TronusPrime/VoiceProject/Mk2BOM.xlsx

Reference | Value | Datasheet | Footprint | Qty | LCSC PART
C1,C13,C14,C15,C16 | 10uF | ~ | Capacitor_SMD:C_0402_1005Metric | 5 | C15525
C2 | 22uF | ~ | Capacitor_SMD:C_0402_1005Metric | 1 | C3845593
C5 | 22uF | ~ | Capacitor_SMD:C_0805_2012Metric | 1 | C29277
C6 | 0.1uF | ~ | Capacitor_SMD:C_0805_2012Metric | 1 | C126469
C3,C4,C7,C8,C9,C10,C12 | 0.1uF | ~ | Capacitor_SMD:C_0402_1005Metric | 7 | C1525
C11 | 2.2uF | ~ | Capacitor_SMD:C_0402_1005Metric | 1 | C60078
C17 | 2.2uF | ~ | Capacitor_SMD:C_0805_2012Metric | 1 | C1728
C18,C19 | 2.2nF | ~ | Capacitor_SMD:C_0402_1005Metric | 2 | C1531
D1 | 3V | ~ | LED_SMD:LED_0603_1608Metric | 1 | C193191
D2 | LED | ~ | LED_SMD:LED_0603_1608Metric | 1 | C2994781
J2 | Conn_01x06_Socket | ~ | B6B_XH_A:JST_B6B-XH-A | 1 | C144397
J3 | Screw_Terminal_01x02 | ~ | B2B_XH_A:JST_B2B-XH-A | 1 | C158012
J4,J5 | Conn_01x03_Socket | ~ | B3B_XH_A:JST_B3B-XH-A | 2 | C161870
R1,R2 | 5.1k | ~ | Resistor_SMD:R_0402_1005Metric | 2 | C25905
R3 | 0 | ~ | Resistor_SMD:R_0402_1005Metric | 1 | C17168
R4 | 10k | ~ | Resistor_SMD:R_0402_1005Metric | 1 | C25744
R5,R6 | 470 | ~ | Resistor_SMD:R_0402_1005Metric | 2 | C25167
R7 | 350 | ~ | Resistor_SMD:R_0402_1005Metric | 1 | C25107
R8 | 100 | ~ | Resistor_SMD:R_0402_1005Metric | 1 | C98836
SW1,SW2 | SW_Push | ~ | Switch:SW2_PTS636 SM25F SMTR LFS_CNK | 2 | C2689642
U1 | AMS1117-3.3 | http://www.advanced-monolithic.com/pdf/ds1117.pdf | Package_TO_SOT_SMD:SOT-223-3_TabPin2 | 1 | C6186
U2 | ESP32-WROOM-E | https://www.espressif.com/sites/default/files/documentation/esp32-wroom-32e_esp32-wroom-32ue_datasheet_en.pdf | Espressif:ESP32-WROOM-32E | 1 | C701343
U3 | PCM5102A | https://www.ti.com/lit/ds/symlink/pcm5102a.pdf | Package_SO:TSSOP-20_4.4x6.5mm_P0.65mm | 1 | C107671
USB1 | TYPE-C 16PIN 2MD(073) |  | easyeda2kicad:USB-C-SMD_TYPE-C-6PIN-2MD-073 | 1 | C2765186
