TronusPrime/VoiceProject/SpeakerR/SpeakerR_BOM.xlsx

Reference | Value | Datasheet | Footprint | Qty | LCSC
C1,C4 | 20uF | ~ | Capacitor_SMD:C_1812_4532Metric | 2 | C76690
C2,C3,C6 | 1uF | ~ | Capacitor_SMD:C_0402_1005Metric | 3 | C52923
C5 | 0.1uF | ~ | Capacitor_SMD:C_0402_1005Metric | 1 | C1581
FB1,FB2 | FerriteBead | ~ | Inductor_SMD:L_0603_1608Metric | 2 | C1002
J1 | Conn_01x02_Socket | ~ | easyeda2kicad:CONN-TH_B2B-XH-A-LF-SN | 1 | C158012
J2 | Conn_01x03_Socket | ~ | easyeda2kicad:CONN-TH_3P-P2.50_B3B-XH-AM-LF-SN | 1 | C161870
R1 | 10k | ~ | Resistor_SMD:0405_1005Metric | 1 | C25531
RV1 | 10k |  | Potentiometer | 1
U1 | PAM8406D | https://www.diodes.com/assets/Datasheets/PAM8406.pdf | Package_SO:SOP-16_3.9x9.9mm_P1.27mm | 1 | C86270
