TronusPrime/VoiceProject/Amp12VMk1PCB/Amp12VMk1PCB.kicad_pcb

## KiCad design Amp12VMk1PCB/Amp12VMk1PCB.kicad_pcb (2024-11-20)

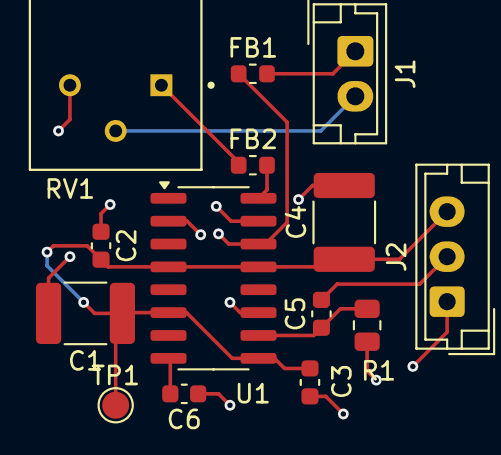
[picture p1: board Amp12VMk1PCB.kicad_pcb from above]

Board: 2 copper layers, 14 parts (0 on the bottom side), 10 nets.

Parts:
C1, C4: 20uF; C_1812_4532Metric
C2, C3, C6: 1uF; C_0603_1608Metric
C5: 0.1uF; C_0603_1608Metric
FB1, FB2: FerriteBead; L_0603_1608Metric
J1: Conn_01x02_Socket; JST_EH_B2B-EH-A_1x02_P2.50mm_Vertical
J2: Conn_01x03_Socket; JST_EH_B3B-EH-A_1x03_P2.50mm_Vertical
R1: 10k; R_0805_2012Metric
RV1: 10k; POT_3310P-025-103L
TP1: TestPoint; TestPoint_Pad_D1.5mm
U1: PAM8406D; SOP-16_3.9x9.9mm_P1.27mm

Connections:
+5V: C1.1, C2.2, C3.2, C4.1, J2.3, TP1.1, U1.4 (PVDDL), U1.6 (VDD), U1.9 (MODE), U1.13 (PVDDR)
/inR: C5.2, J2.2
GND: C1.2, C2.1, C3.1, C4.2, C6.1, J2.1, R1.1, RV1.3, U1.2 (PGNDL), U1.11 (GND), U1.15 (PGNDR)
unnamed: FB2.1, RV1.1
unnamed: FB1.2, J1.1
unnamed: J1.2, RV1.2
unnamed: FB2.2, U1.16 (+OUT_R)
unnamed: FB1.1, U1.14 (-OUT_R)
unnamed: C5.1, R1.2, U1.10 (INR)
unnamed: C6.2, U1.8 (VREF)
