TronusPrime/VoiceProject/MicPCB/MicPCB/MicPCB.kicad_pcb

## KiCad design MicPCB/MicPCB/MicPCB.kicad_pcb (2024-11-20)

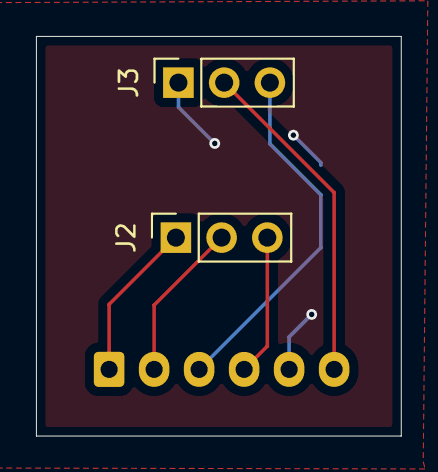
[picture p5: board MicPCB.kicad_pcb from above]

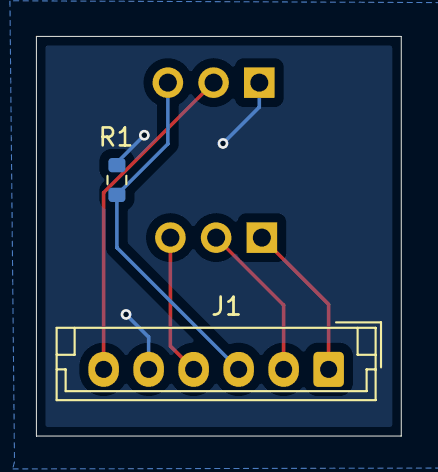
[picture p6: board MicPCB.kicad_pcb from below]

Board: 2 copper layers, 20.3 x 22.2 mm, 4 parts (2 on the bottom side), 6 nets.

Parts:
J1: 3.3 sel; JST_EH_B6B-EH-A_1x06_P2.50mm_Vertical
J2, J3: Conn_01x03_Socket; PinSocket_1x03_P2.54mm_Vertical
R1: 10k; R_0603_1608Metric

Connections:
+3.3V: J1.6, J3.2
/bclk: J1.4, J2.3
/lrcl: J1.2, J2.2
/sd: J1.3, J3.3, R1.1
/sel: J1.1, J2.1
GND: J1.5, J3.1, R1.2
