TronusPrime/VoiceProject/VoiceProjectPCB/VoiceProjectPCB.kicad_pcb

## KiCad design VoiceProjectPCB/VoiceProjectPCB.kicad_pcb (2024-11-20)

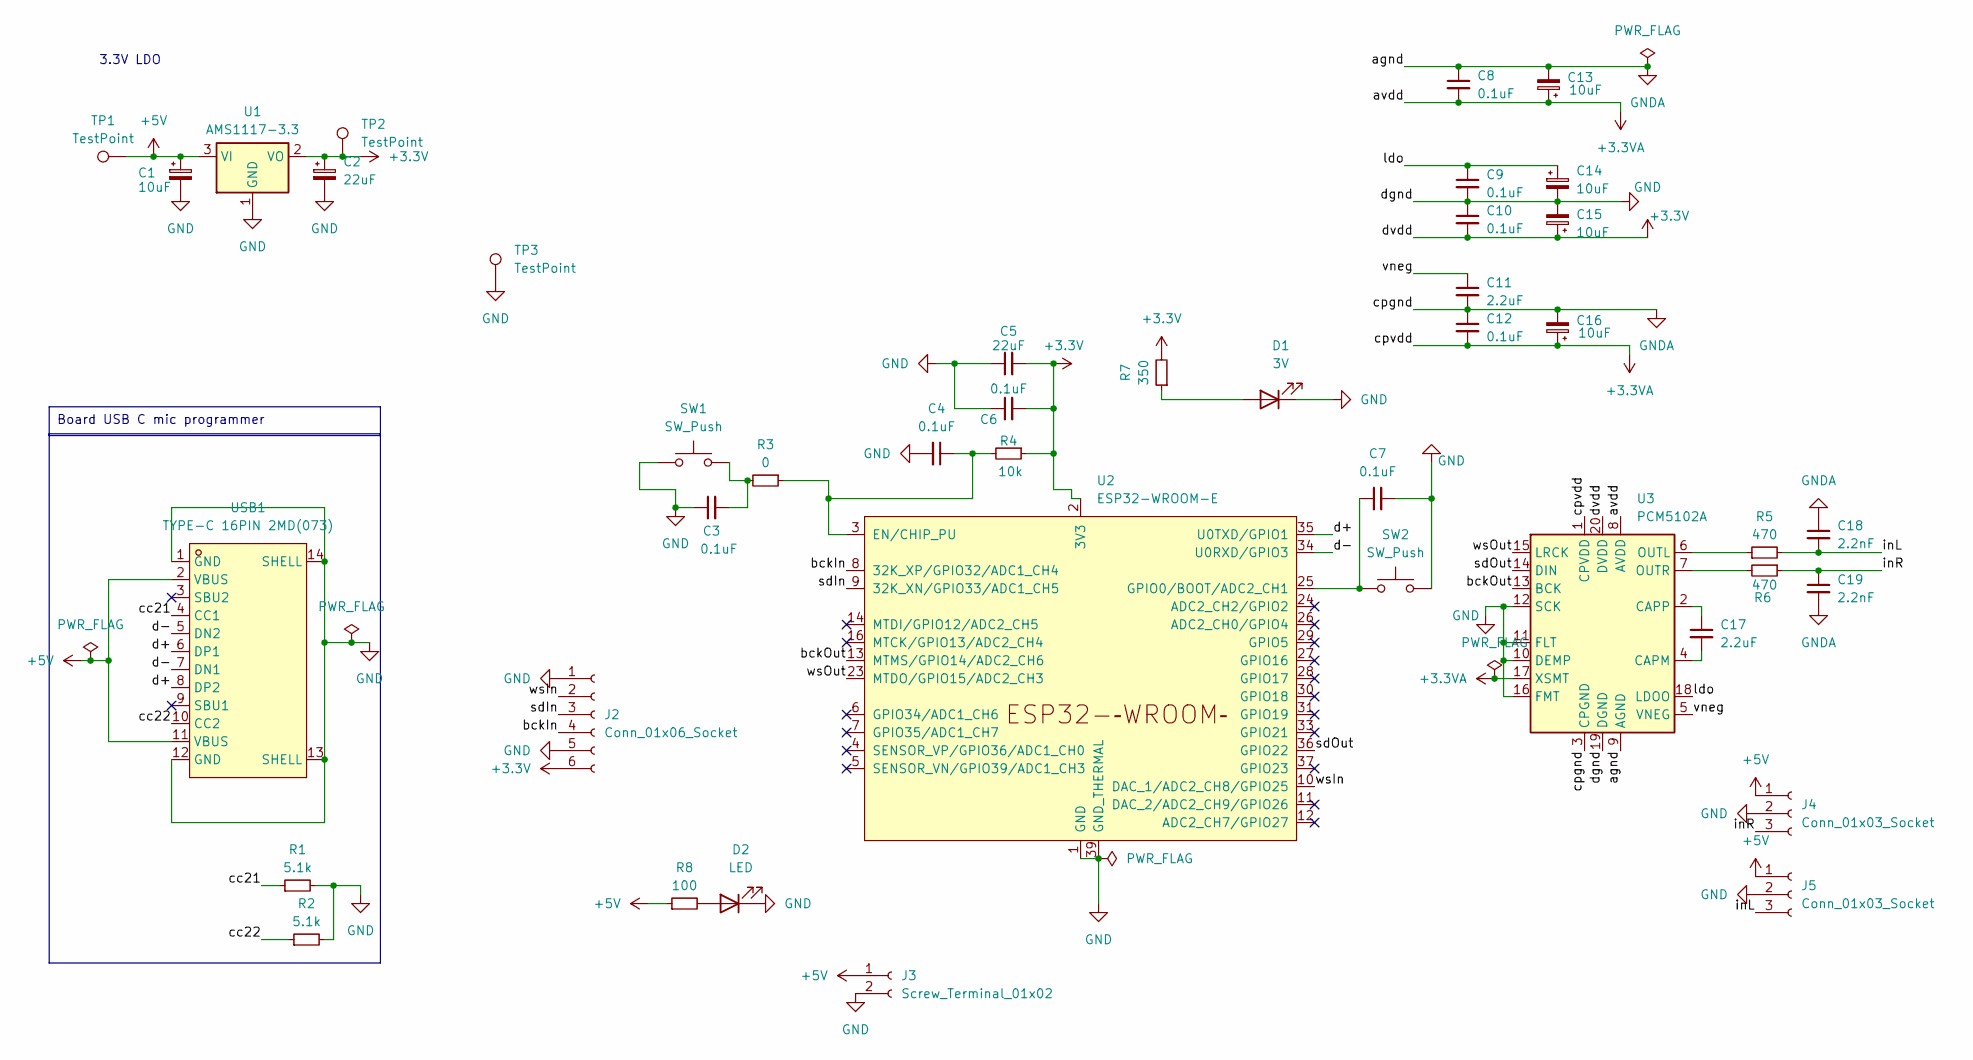
[picture p7: schematic VoiceProjectPCB.kicad_sch]

Parts:
C1, C13, C14, C15, C16: 10uF; C_0402_1005Metric
C2: 22uF; C_0402_1005Metric
C3, C4, C7, C8, C9, C10, C12: 0.1uF; C_0402_1005Metric
C5: 22uF; C_0805_2012Metric_Pad1.18x1.45mm_HandSolder
C6: 0.1uF; C_0805_2012Metric_Pad1.18x1.45mm_HandSolder
C11: 2.2uF; C_0402_1005Metric
C17: 2.2uF; C_0805_2012Metric_Pad1.18x1.45mm_HandSolder
C18, C19: 2.2nF; C_0402_1005Metric
D1: 3V; LED_0603_1608Metric
D2: LED; LED_0603_1608Metric
J2: Conn_01x06_Socket; JST_B6B-XH-A
J3: Screw_Terminal_01x02; JST_B2B-XH-A
J4, J5: Conn_01x03_Socket; JST_B3B-XH-A
R1, R2: 5.1k; R_0402_1005Metric
R3: 0; R_0402_1005Metric
R4: 10k; R_0402_1005Metric
R5, R6: 470; R_0402_1005Metric
R7: 350; R_0402_1005Metric
R8: 100; R_0402_1005Metric
SW1, SW2: SW_Push; SW2_PTS636 SM25F SMTR LFS_CNK
TP1, TP2, TP3: TestPoint; TestPoint_Pad_D1.5mm
U1: AMS1117-3.3; SOT-223-3_TabPin2
U2: ESP32-WROOM-E; ESP32-WROOM-32E
U3: PCM5102A; TSSOP-20_4.4x6.5mm_P0.65mm
USB1: TYPE-C 16PIN 2MD(073); USB-C-SMD_TYPE-C-6PIN-2MD-073; LCSC Part C2765186

Connections:
+3.3V: C2.1, C5.2, C6.2, C10.2, C15.1, J2.6, R4.1, R7.2, TP2.1, U1.2 (VO), U2.2 (3V3), U3.20 (DVDD)
+3.3VA: C8.2, C12.2, C13.1, C16.1, U3.1 (CPVDD), U3.8 (AVDD), U3.17 (XSMT)
+5V: C1.1, J3.1, J4.1, J5.1, R8.1, TP1.1, U1.3 (VI), USB1.2 (VBUS), USB1.11 (VBUS)
/bckIn: J2.4, U2.8 (32K_XP/GPIO32/ADC1_CH4)
/bckOut: U2.13 (MTMS/GPIO14/ADC2_CH6), U3.13 (BCK)
/cc21: R1.1, USB1.4 (CC1)
/cc22: R2.1, USB1.10 (CC2)
/d+: U2.35 (U0TXD/GPIO1), USB1.6 (DP1), USB1.8 (DP2)
/d-: U2.34 (U0RXD/GPIO3), USB1.5 (DN2), USB1.7 (DN1)
/inL: C18.2, J5.3, R5.2
/inR: C19.1, J4.3, R6.1
/ldo: C9.1, C14.1, U3.18 (LDOO)
/sdIn: J2.3, U2.9 (32K_XN/GPIO33/ADC1_CH5)
/sdOut: U2.36 (GPIO22), U3.14 (DIN)
/vneg: C11.1, U3.5 (VNEG)
/wsIn: J2.2, U2.10 (DAC_1/ADC2_CH8/GPIO25)
/wsOut: U2.23 (MTDO/GPIO15/ADC2_CH3), U3.15 (LRCK)
GND: C1.2, C2.2, C3.1, C4.2, C5.1, C6.1, C7.2, C9.2, C10.1, C14.2, C15.2, D1.1 (K), D2.1 (K), J2.1, J2.5, J3.2, J4.2, J5.2, R1.2, R2.2, SW1.1, SW2.2, TP3.1, U1.1 (GND), U2.1 (GND), U2.15 (GND), U2.38 (GND), U2.39 (GND_THERMAL), U3.10 (DEMP), U3.11 (FLT), U3.12 (SCK), U3.16 (FMT), U3.19 (DGND), USB1.1 (GND), USB1.12 (GND), USB1.13 (SHELL), USB1.14 (SHELL)
GNDA: C8.1, C11.2, C12.1, C13.2, C16.2, C18.1, C19.2, U3.3 (CPGND), U3.9 (AGND)
unnamed: C3.2, R3.2, SW1.2
unnamed: D1.2 (A), R7.1
unnamed: D2.2 (A), R8.2
unnamed: C4.1, R3.1, R4.2, U2.3 (EN/CHIP_PU)
unnamed: C7.1, SW2.1, U2.25 (GPIO0/BOOT/ADC2_CH1)
unnamed: C17.2, U3.4 (CAPM)
unnamed: C17.1, U3.2 (CAPP)
unnamed: R5.1, U3.6 (OUTL)
unnamed: R6.2, U3.7 (OUTR)

Notes on the sheet:
Board USB C mic programmer
3.3V LDO

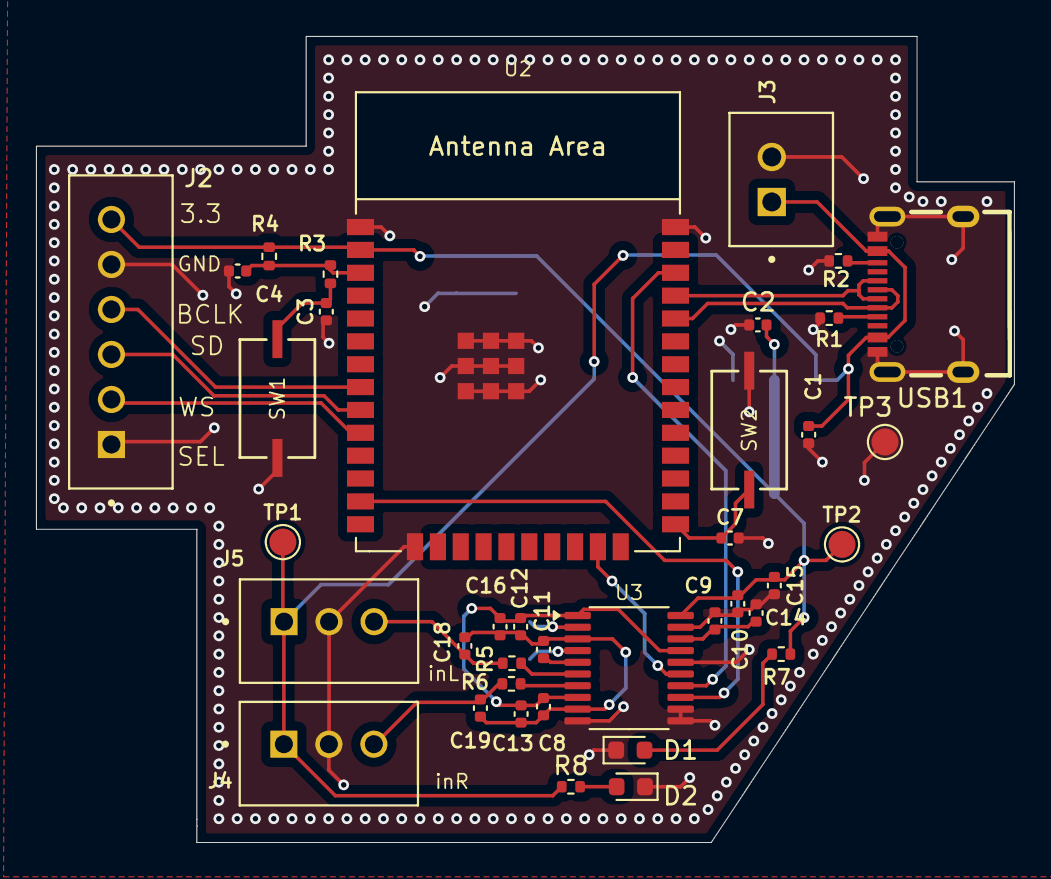
[picture p8: board VoiceProjectPCB.kicad_pcb from above]

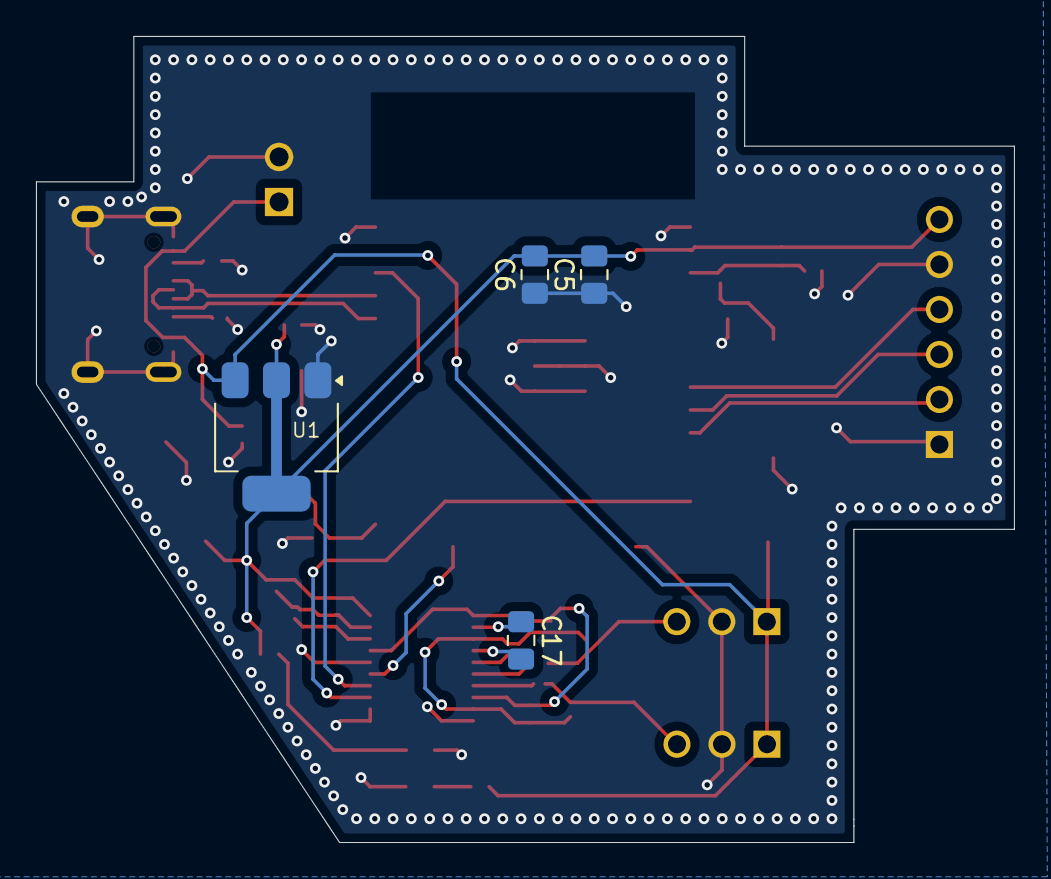
[picture p9: board VoiceProjectPCB.kicad_pcb from below]

Board: 2 copper layers, 54.3 x 44.8 mm, 42 parts (4 on the bottom side), 28 nets.
