TronusPrime/VoiceProject/(commit log)

2024-10-29 Add files via upload
    Moved Project to Github Repo. Current Code: Mk3. Current PCB: Mk1
    [VoiceProjectPCB-B_Cu.gbr, VoiceProjectPCB-B_Mask.gbr, VoiceProjectPCB-B_Paste.gbr, VoiceProjectPCB-B_Silkscreen.gbr, VoiceProjectPCB-Edge_Cuts.gbr, VoiceProjectPCB-F_Cu.gbr, VoiceProjectPCB-F_Mask.gbr, VoiceProjectPCB-F_Paste.gbr]
2024-11-20 Mk 2 PCB, Switched to DSP for Voice Modulation
    [Amp12VMk1PCB.kicad_pcb, Amp12VMk1PCB.kicad_sch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]
